SpikedCola/bullet-microphone/pcb/Electret Mic Preamp v1.1 BOM.csv

Qty | Value | Part Num | Package | Parts
2 |  | * | R0603 | FB1, FB2
1 | 1n | * | C0603 | C8
2 | 2.2k | * | R0603 | R10, R11
3 | 10k | * | R0603 | R1, R3, R5
1 | 10u | * | E1,8-4 | C1
1 | 16V | * | SOD-123 | D1
3 | 33k | * | R0603 | R6, R7, R9
3 | 33u | * | E2,5-6 | C2, C3, C9
2 | 100 | * | R0603 | R12, R13
2 | 100k | * | R0603 | R2, R4
1 | 100n | * | C0603 | C7
2 | 100u | * | E2,5-6 | C4, C5
1 | 220 | * | R0603 | R8
1 | BC849 | * | SOT23-3 | Q1
3 | BC859 | * | SOT23-3 | Q2, Q3, Q4
1 | Mic | * | 1X02 | J1
1 | Out | * | 1X03 | J2
