SpikedCola/bullet-microphone/case/Microphone Body.SLDPRT

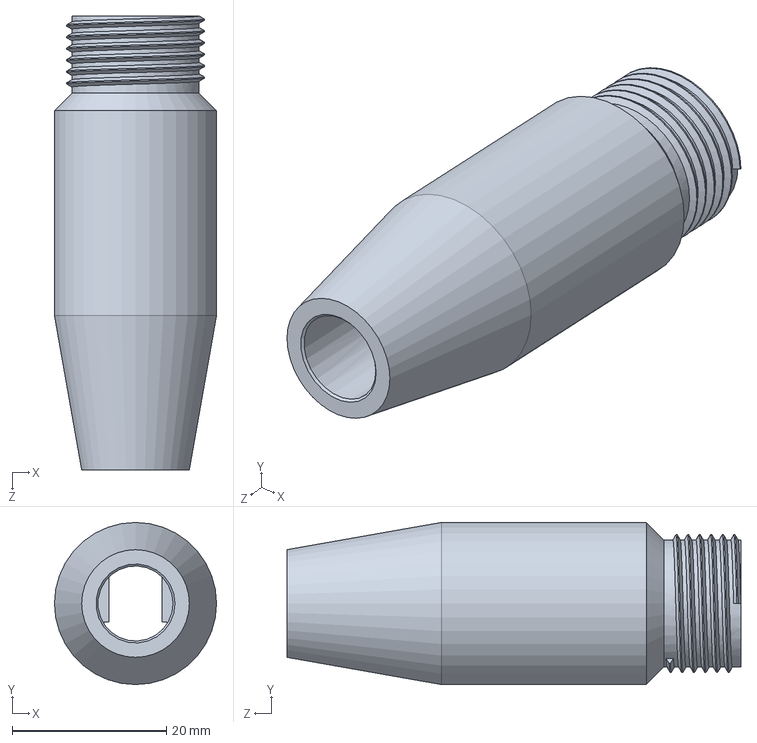
[picture p13: CAD file, 2026-11-10]
case/Microphone Body.SLDPRT
21.0 x 21.0 x 58.8 mm
