SpikedCola/bullet-microphone/case/Microphone Cap.SLDPRT

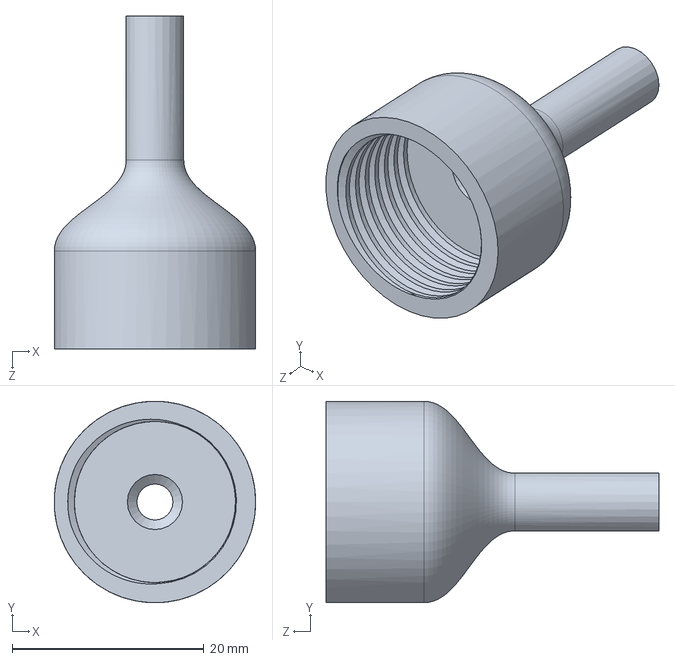
[picture p14: CAD file, 2026-11-10]
case/Microphone Cap.SLDPRT
21.0 x 21.0 x 34.7 mm
