SpikedCola/bullet-microphone/(list of files, cad)

Other CAD files:
case/Microphone Body.STL
case/Microphone Cap.STL
