SpikedCola/bullet-microphone/pcb/Electret Mic Preamp v1.1 - Assembly Diagram.pdf

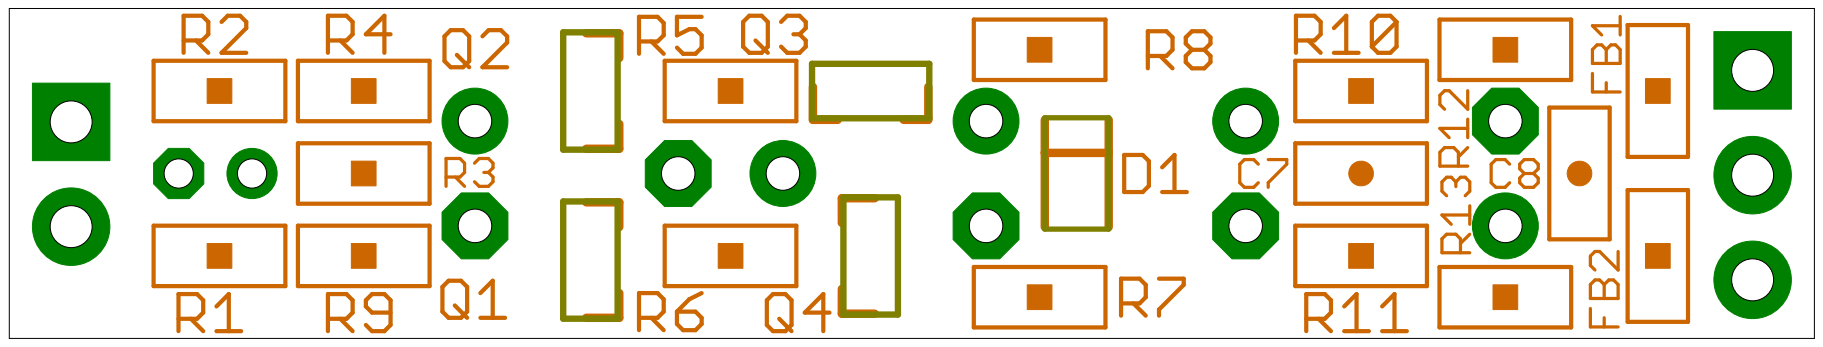
[picture p15: page 1]
