SpikedCola/bullet-microphone/pcb/Electret Mic Preamp v1.1 - Schematic.pdf

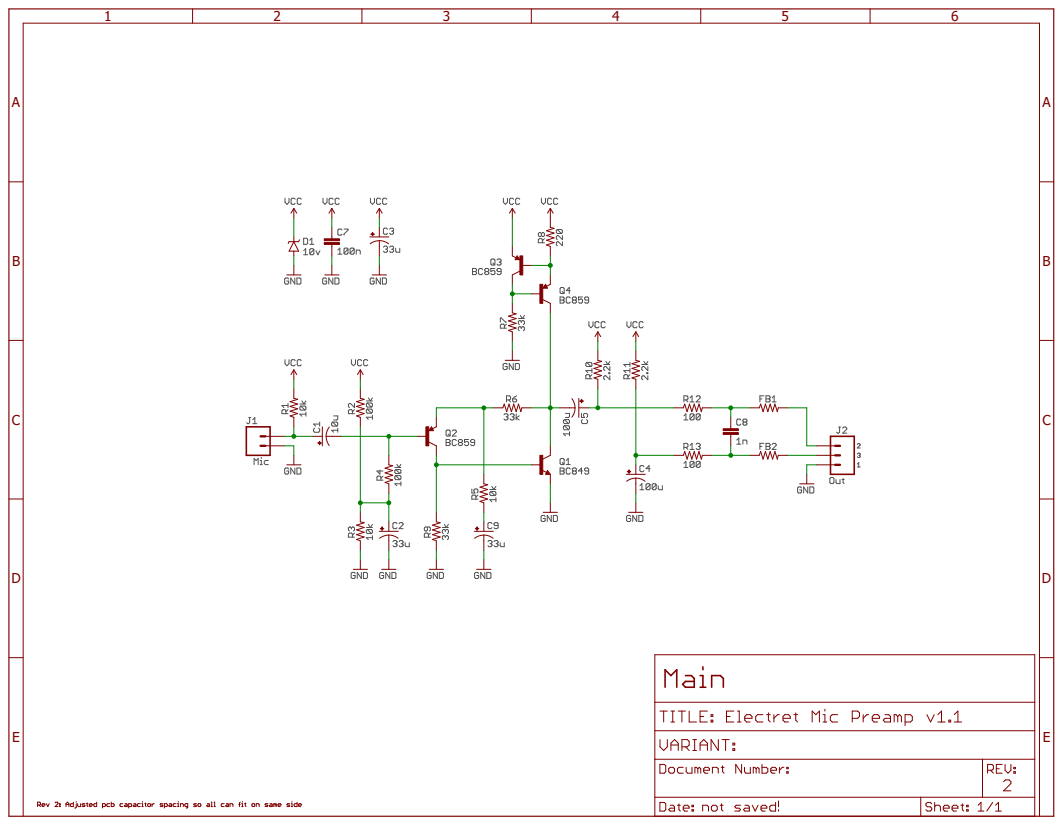
[picture p16: page 1]
