SpikedCola/bullet-microphone/pcb/Electret Mic Preamp v1.1.brd

## EAGLE design pcb/Electret Mic Preamp v1.1.brd (2026-11-10)

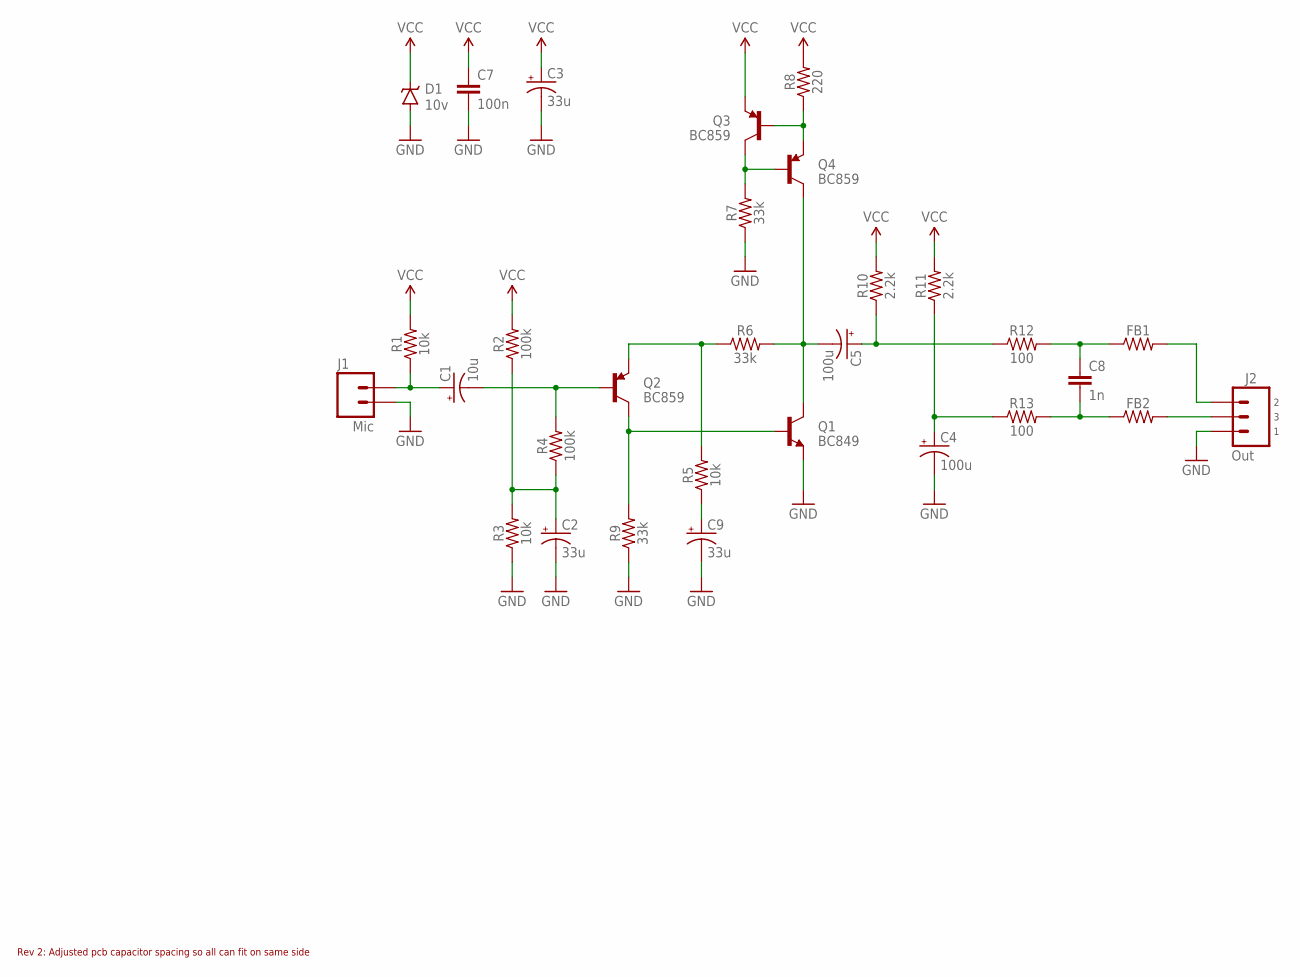
[picture p17: schematic Electret Mic Preamp v1.1.sch]

Parts:
C1: 10u; E1,8-4
C2, C3, C9: 33u; E2,5-6
C4, C5: 100u; E2,5-6
C7: 100n; C0603
C8: 1n; C0603
D1: 10v; SOD-123
FB1, FB2: RESISTORR0603; R0603
J1: Mic; 1X02
J2: Out; 1X03
Q1: BC849; SOT23-3
Q2, Q3, Q4: BC859; SOT23-3
R1, R3, R5: 10k; R0603
R2, R4: 100k; R0603
R6, R7, R9: 33k; R0603
R8: 220; R0603
R10, R11: 2.2k; R0603
R12, R13: 100; R0603

Connections:
GND: C2.-, C3.-, C4.-, C7.2, C9.-, D1.A, J1.2, J2.3, Q1.2 (E), R3.1, R7.1, R9.1
unnamed: C1.+, J1.1, R1.1
unnamed: Q3.3 (C), Q4.1 (B), R7.2
unnamed: C2.+, R2.1, R3.2, R4.1
unnamed: C1.-, Q2.1 (B), R4.2
unnamed: Q2.2 (E), R5.2, R6.1
unnamed: Q1.1 (B), Q2.3 (C), R9.2
unnamed: C9.+, R5.1
unnamed: Q3.1 (B), Q4.2 (E), R8.1
unnamed: C5.-, Q1.3 (C), Q4.3 (C), R6.2
unnamed: C5.+, R10.1, R12.1
unnamed: C4.+, R11.1, R13.1
unnamed: C8.1, FB1.1, R12.2
unnamed: C8.2, FB2.1, R13.2
unnamed: FB2.2, J2.2
unnamed: FB1.2, J2.1
VCC: C3.+, C7.1, D1.C, Q3.2 (E), R1.2, R2.2, R8.2, R10.2, R11.2

Notes on the sheet:
Rev 2: Adjusted pcb capacitor spacing so all can fit on same side

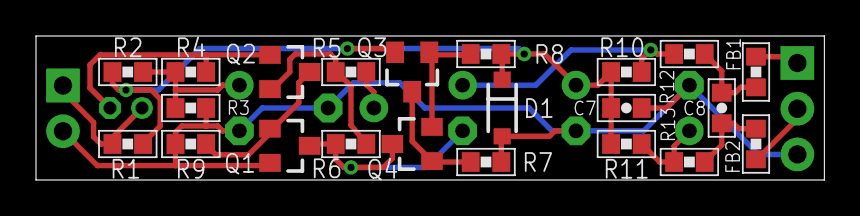
[picture p18: board Electret Mic Preamp v1.1.brd from above]

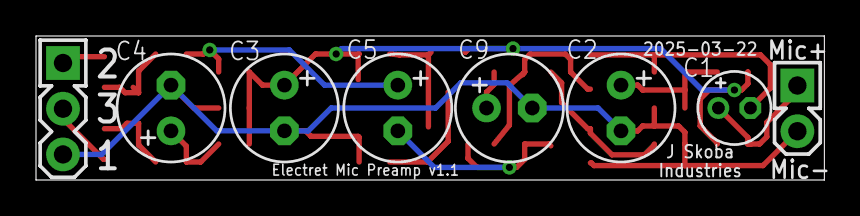
[picture p19: board Electret Mic Preamp v1.1.brd from below]

Board: 2 copper layers, 43.8 x 8.0 mm, 30 parts (8 on the bottom side), 17 nets.
